MOBILAB-UDESC/PincOpen/cad/step/Interface_G1_Plate.step

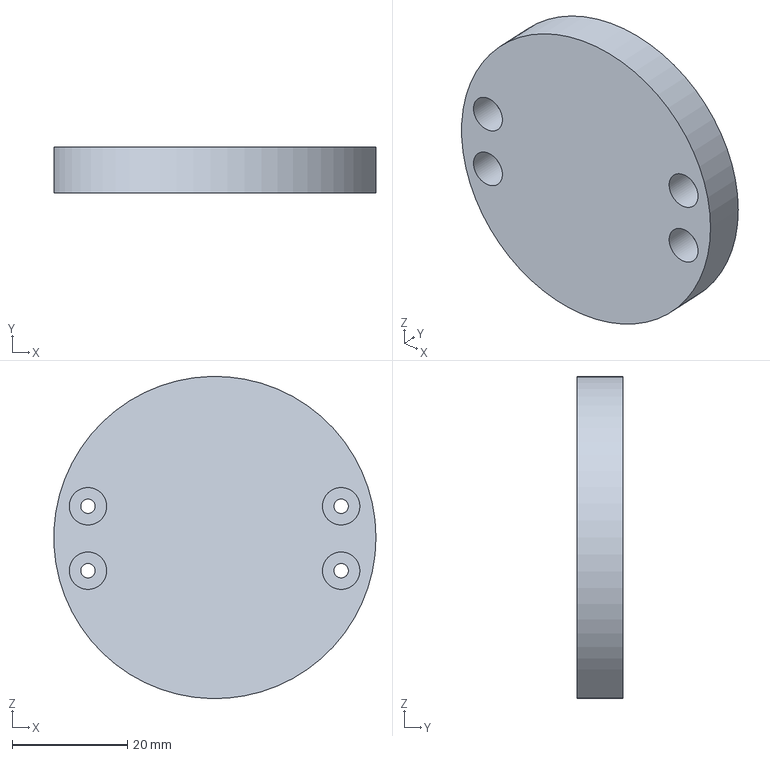
[picture p3: CAD file, 2026-11-04]
cad/step/Interface_G1_Plate.step
56.0 x 8.00 x 56.0 mm
