MOBILAB-UDESC/PincOpen/cad/stl/Interface_G1.stl

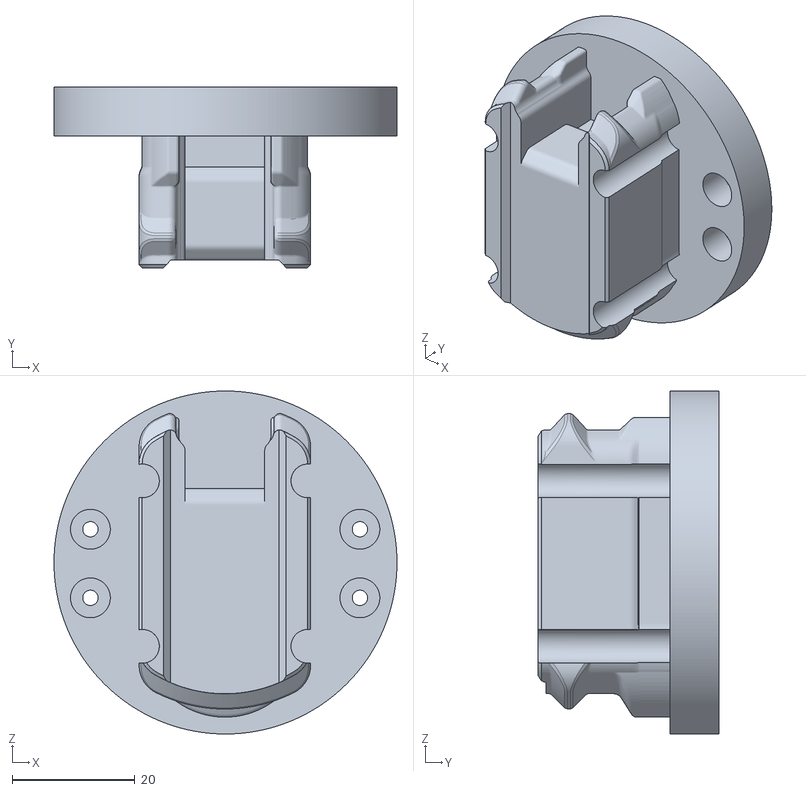
[picture p4: CAD file, 2026-11-04]
cad/stl/Interface_G1.stl
56.0 x 29.5 x 56.0
