MOBILAB-UDESC/PincOpen/docs/changelog.md

# Updates history

## v1.0 - 10/03/2025
- Publish the project
- Includes BOM, Assembly guide etc...

## v1.0 - 27/03/2025
### Added
- Stencil on Onshape to cut a rubber/tape cover for the tips
- New post added : **Fingertips for Better Grip**

### Fixed
- BoM mistakes

## MOBILAB-UDESC fork - 03/11/2026
### Added
- `Interface_G1`: adapter for the Unitree G1 wrist clamp (STL, plate STEP, build script in `cad/g1/`)
- `docs/g1_wrist_interface.md`: G1 wrist dimensions, sources, wiring and fitting notes
